thundergrj/Lumimoon-Tech-RobotDuck/致谢与许可.md

# 致谢与许可

## 致谢

这份中文组装调试教程，建立在一系列开源工作之上：

- **MicroDuck** — 由 Hugging Face / Pollen Robotics 开创的开源双足机器鸭，公开了软件栈与训练生态，让这只可爱的小鸭子走进全球开发者视野。
  https://pollen-robotics.com/microduck/
- **OpenMicroDuck** — 社区对 MicroDuck 的开源复刻项目，公开了适配国产供应链的硬件图纸、PCB、BOM、结构优化与文档。本教程的硬件知识、结构设计说明、选型逻辑主要整理、复述并再创作自该项目。
  https://github.com/JoyandAI/OpenMicroDuck
- **microduck_rl（HD-1910 适配 fork）** — 为飞特 HD-1910 舵机适配了执行器（BAM）参数的训练仓库。
  https://github.com/JoyandAI/microduck_rl

本教程是**独立编写**的中文装配 / 调试文档，为便于中文用户上手而重新组织、重写了内容，并补充了针对具体套件（HD-1910 C018、微雪控制板、IMX219 160°、LSM6DSV16X 桌面调试版等）的实操说明。本教程与上述团队 / 公司无隶属关系。

如内容有误或可改进，欢迎到 OpenMicroDuck 仓库提 Issue / PR，一起把中文文档做得更好。

## 许可

本教程文档采用 **CC BY-SA 4.0**（署名—相同方式共享），与上游 OpenMicroDuck 的教程 / 文档许可一致：

- **署名（BY）**：复制、修改、再分发时，请保留对 OpenMicroDuck / MicroDuck 的署名与来源链接。
- **相同方式共享（SA）**：基于本教程的衍生作品，需以相同的 CC BY-SA 许可发布。

硬件相关内容的许可以上游项目为准：

| 内容 | 许可 |
| --- | --- |
| 硬件图纸、PCB、BOM | CERN-OHL-S |
| 软件栈、训练环境 | Apache-2.0 |
| 教程与文档 | CC BY-SA 4.0 |

> 图片说明：本仓库 `assets/` 下为占位示例，请替换为你自己拍摄 / 制作的图片。请勿直接搬运上游项目的图片而不署名。
