thundergrj/Lumimoon-Tech-RobotDuck/docs/11_接口与参数速查.md

# 09 · 接口与参数速查

装配、接线、调试时随手查这一页。

---

## 1. 舵机 ID 规划

```text
右腿   10 右髋yaw · 11 右髋roll · 12 右髋pitch · 13 右膝 · 14 右踝
左腿   20 左髋yaw · 21 左髋roll · 22 左髋pitch · 23 左膝 · 24 左踝
头颈嘴 30 脖pitch · 31 头pitch · 32 头yaw · 33 头roll · 34 鸭嘴
机身IMU 200（仅整机集成版，串在舵机链中 31 与 20 之间；桌面调试版 IMU 走主控 I²C，不用此 ID）
```

鸭嘴（34）是第 15 轴，**不参与走路策略**，由上层逻辑单独开合。

---

## 2. HD-1910 舵机关键参数

> 以 HD-1910 系列规格为参考（你的套件为 C018 批次，具体以随附规格书为准）。

| 项目 | 参数 |
| --- | --- |
| 类型 | 恒力空心杯总线舵机，金属齿 |
| 工作电压 | **4 – 8.4 V**（本套件用 7.5V 适配器） |
| 堵转扭矩 | 约 **12 kg·cm @ 6V**（约 1.18 N·m） |
| 额定扭矩 | 约 3 kg·cm @ 6V |
| 空载转速 | 约 92 rpm @ 6V |
| 减速比 | 320 : 1 |
| 编码器 | 12-bit 磁编码（0–4095，中位约 2048） |
| 接口 | **AMP2.0-3P** |
| 协议 | 飞特 TTL 半双工，8N1，数字包 |
| 通信波特率 | 统一设为 **1 Mbps** |
| 反馈 | 位置 / 速度 / 电流 / 电压 / 温度 / 负载 |
| ID 范围 | 0–253（出厂常见 ID 1） |

---

## 3. ⚠️ 针序对照（接线必看）

| 针位 | HD-1910（AMP2.0-3P） | Dynamixel / 飞特 HL 等 |
| --- | --- | --- |
| 1 | **Signal 信号** | GND 地 |
| 2 | Vcc 电源 | Vcc 电源 |
| 3 | **GND 地** | Signal 信号 |

> HD-1910 与 Dynamixel 针序**相反**，不能按 Dynamixel 线序直插。接 AMP2.0 转 5264 转接线前务必核对。

---

## 4. 波特率寄存器值对照（飞特 / Dynamixel 同类）

| 寄存器值 | 波特率 |
| --- | --- |
| 1 | 57 600（常见出厂默认） |
| 2 | 115 200 |
| **3** | **1 000 000（1 Mbps，本项目用）** |
| 4 | 2 000 000 |

> 出厂默认常不是 1 Mbps。用当前波特率扫到后，改成 1 Mbps 再统一使用。

---

## 5. 轴承用量

| 轴承 | 规格 | 数量 | 用途 |
| --- | --- | --- | --- |
| 6700K | 10 × 15 × 3 mm | 3 | 较小旋转关节 |
| ET2216 | 16 × 22 × 4 mm | 11 | 踝 / 腿等主要承重旋转处 |

## 6. 螺丝用量

| 规格 | 数量 | 用途 |
| --- | --- | --- |
| M2 × 5 自攻 | 60 | 锁大部分结构 |
| M2 × 6 自攻 | 60 | 锁舵盘、脚 |
| M2 × 8 自攻 | 20 | 锁舵机（成品版多为备用） |
| M2.5 × 6 自攻 | 20 | 头部内部结构 |

---

## 7. 主控（Radxa ZERO 3W）与鸭子相关接口

| 接口 | 用途 |
| --- | --- |
| UART2_M0（40-pin 8 脚 TX / 10 脚 RX） | 舵机总线（整机集成版经 HAT）。**系统里默认被 serial-getty 占用，需 mask**；开机阶段是 U-Boot 调试口（1500000） |
| I²C3（40-pin 3/5 脚） | IMU（桌面调试版）、ToF、codec |
| MIPI CSI（22-pin） | IMX219 摄像头 |
| I²S | 喇叭 / codec |
| USB-C 1（OTG） | **唯一供电口**，仅 5V（≥ 5V/2A）+ 刷机 |
| USB-C 2（USB 3.2 Host） | 接外设（如 USB 舵机驱动板），**不能供电** |
| Micro HDMI | 1080p60 显示（配置时用） |
| Wi-Fi 6 / BT 5.4 | 配网 / 蓝牙 |

> 完整接口与引脚说明：[Radxa ZERO 3 硬件接口文档](https://docs.radxa.com/zero/zero3/hardware-design/hardware-interface)；接口实物图见 [08 章 §0](08_主控系统与刷机.md)。

---

## 8. 控制契约（软件）

| 项 | 值 |
| --- | --- |
| 控制频率 | 50 Hz |
| 观测维度 | 61（陀螺 3 + 重力投影 3 + 关节位置 14 + 关节速度 14 + 上一动作 14 + 指令 13） |
| 动作维度 | 14（14 个走路关节，不含鸭嘴） |
| 策略格式 | ONNX（主控 CPU 上用 ONNX Runtime 跑） |
| 走路是否用 NPU | 否（NPU 留给视觉） |

---

## 9. 供电速查

| 对象 | 供电 |
| --- | --- |
| 舵机 + 控制板 | 7.5V 适配器（范围内） |
| 主控 | 5V/2–3A PD（Type-C） |
| IMU 模组 | 3.3V（**勿接 5V**） |
