thundergrj/Lumimoon-Tech-RobotDuck/docs/06_通电自检与联调.md

# 06 · 通电自检与联调

到这一步，机械装好了、舵机也都编好号校好中位了。本章把整条总线一起通电，做系统级自检，让机器鸭第一次整机"活"起来。

---

## 路线一用户看这里（成品 / 半成品套件）

如果你买的是舵机已装好的整机 / 半成品，前面 02 / 03 跳过没关系，但 **04 接线和 05 舵机调试这两步不能省**：

1. 先读 [04 电子接线](04_电子接线与舵机总线.md)，把控制板、电源、（主控 / IMU / 摄像头）接好。
2. 再按 [05 舵机调试](05_舵机调试_ID与中位校准.md) **确认** 15 个舵机的 ID、波特率、中位。
   - 成品版通常出厂已编好 ID。你要做的是**验证**：整条总线一起扫，看是否能扫到全部 15 个 ID（见下）。
   - 如果扫不全，照 [05](05_舵机调试_ID与中位校准.md) 把缺的那个单独接出来补设。

然后回到本章做整机自检。

---

## 1. 上电顺序与检查

**接线确认 → 上电 → 观察**，别颠倒。

1. 再过一遍 [04 的接线检查清单](04_电子接线与舵机总线.md)。
2. 先给**主控**上电（5V PD），让它正常启动。
3. 再给**舵机总线**上电（7.5V 适配器）。
4. 上电瞬间盯住：有没有哪个舵机**异常发烫、冒烟、剧烈抖动**，有没有闻到焦味。任何异常**立刻断电**，回 [04](04_电子接线与舵机总线.md) 查线序 / 短路。

> 分开两路电源的好处：万一舵机那路有问题，主控不受影响，排查更清楚。

---

## 2. 整线扫描：15 个舵机一个都不能少

把全部 15 个舵机串好、通电，用上位机（或主控上的扫描工具）在 **1 Mbps** 下扫描整条总线：

- 期望扫到 **15 个 ID**：10–14、20–24、30–34。
- **对照检查**：

| 应扫到的 ID | 部位 | 扫到? |
| --- | --- | --- |
| 10 11 12 13 14 | 右腿 5 关节 | ☐ |
| 20 21 22 23 24 | 左腿 5 关节 | ☐ |
| 30 31 32 33 | 脖 + 头三轴 | ☐ |
| 34 | 鸭嘴 | ☐ |

扫不全时的常见原因：

- 少某一个 → 那个舵机线没串好 / 转接处接触不良 / 它的波特率没统一到 1 Mbps。
- 一个都扫不到 → 控制板到总线那段线序错（特别是 1 = 信号这一点，见 [04 §3](04_电子接线与舵机总线.md)）、或没供电、或串口选错。
- 两个 ID 冲突（扫到的数量少于 15 且某动作时两个一起动）→ 有重复 ID，逐个排查重设。

---

## 3. 整机回中位：看站姿

全部扫到后，让所有关节回到中位：

- 机器鸭应能**对称地站直**：双腿对称、双脚平行着地、头正对前方、鸭嘴闭合。
- 哪里不对，就能反推哪个关节中位没校准好：
  - 一条腿比另一条歪 → 查该腿对应关节的中位和装配角度。
  - 脚不平、前倾后仰 → 查踝 / 髋 pitch。
  - 头歪 → 查头三轴（31/32/33）。

> 第一次让整机站立时，**用手扶着**或让它坐在支架上，别让它直接自己站——还没有平衡策略，它是会倒的。

> 📷 *待补拍：整机回中位，扶着确认对称站姿*

---

## 4. 分部位点动联调

确认站姿后，分部位做小幅点动，验证每个关节在整机状态下都正常：

1. **头颈**：让头 yaw / pitch / roll 各小幅转动，确认转向正确、不打架、不蹭壳。
2. **鸭嘴**：开合几次，确认顺畅（卡顿参考 [02](02_3D打印指南.md) / [10 FAQ](10_常见问题FAQ.md) 的 `jaw_soft` 处理）。
3. **腿部**：悬空（把鸭子托起或架高，脚不落地）状态下，让髋 / 膝 / 踝小幅活动，确认左右对称、方向正确。
4. 全程留意电流 / 温度反馈，有持续高电流或快速升温的关节，先停下查机械是否卡滞。

> **安全第一**：联调点动阶段，幅度从小到大；腿部测试尽量悬空做，避免它突然发力把自己掀翻或夹到手。

---

## 5. IMU 自检（桌面调试版）

- 在主控上确认能读到 LSM6DSV16X（I²C 能扫到地址、能读出陀螺仪 / 加速度数据）。
- 轻轻倾斜 / 转动机体，数据应随之变化；静止时陀螺仪接近 0、加速度指示重力方向。
- 这步为后续平衡控制环打基础。具体读取方法见 [08 主控系统与刷机](08_主控系统与刷机.md)。

---

## 6. 联调验收

- [ ] 整线扫描能稳定扫到全部 15 个舵机（1 Mbps）
- [ ] 回中位后整机对称站立（扶着）
- [ ] 头颈、鸭嘴、双腿分部位点动正常、方向正确、不蹭壳
- [ ] 无持续过流 / 过热关节
- [ ] IMU 能读数、随姿态变化

到这里，**硬件装配与调试就全部完成了**——你已经有一只"装好、接好、能动、能感知"的机器鸭。接下来是让它自己站稳、会走的软件与策略部分 → [08 主控系统与刷机](08_主控系统与刷机.md) · [09 仿真、步态与强化学习](09_仿真步态与强化学习.md)

遇到问题先查 [10 常见问题 FAQ](10_常见问题FAQ.md)。
