thundergrj/Lumimoon-Tech-RobotDuck/docs/01_物料清单与工具.md

# 01 · 物料清单与工具

本章先带你把到手的一整套东西清点一遍：每样是什么、派什么用、为什么是这个规格。装之前花十分钟对清单，比装到一半发现缺件强得多。

> 本教程按**有线调试套件**（桌面调试版）编写：主控和舵机控制板放在机体外面，用电源适配器供电、数据线连电脑，先把控制和策略跑通。这是最稳的入门路径。等整机集成版的 HAT 转接板就绪后，再把电池和线束收进机体。

---

## 1. 整套物料总览

下表是一套完整有线调试套件的内容。**标配**是机器鸭本体必须的；**赠送**是装配要用到的结构件与五金；**选配（有线调试散件）**是把它调起来、让它"活"过来的那部分电子件。

### 标配

| 物料 | 型号 / 规格 | 数量 | 说明 |
| --- | --- | --- | --- |
| 舵机 | 飞特 HD-1910（C018 批次） | 15 | 恒力空心杯总线舵机，机器鸭的 15 个关节。**成品套件中已装在机体上**；散件套件则需自行安装 |

> **关于"15 个舵机"**：腿部每条 5 个（髋 yaw / roll / pitch + 膝 + 踝），左右共 10 个；头颈 4 个（脖子 pitch、头 pitch / yaw / roll）；鸭嘴 1 个。鸭嘴这颗（第 15 轴）不参与走路策略，由上层逻辑单独开合。

### 赠送（结构件与五金）

| 物料 | 规格 | 数量 | 说明 |
| --- | --- | --- | --- |
| 小鸭子打印件 | PLA + 脚底 TPU | 1 套 | 整机外壳与结构件。颜色分组见下 |
| 轴承 6700K | 10 × 15 × 3 mm | 3 | 用于较小的旋转关节 |
| 轴承 ET2216 | 16 × 22 × 4 mm | 11 | 用于踝 / 腿等主要承重旋转处 |
| 螺丝 | M2 × 5 自攻 | 60 | 锁大部分结构 |
| 螺丝 | M2 × 6 自攻 | 60 | 锁舵盘、脚等 |
| 螺丝 | M2 × 8 自攻 | 20 | 锁舵机（成品版舵机已装好，这部分多为备用 / 少量加固） |
| 螺丝 | M2.5 × 6 自攻 | 20 | 头部内部结构固定 |
| 转接线 | AMP2.0 转 5264（AMP 转 5264 端子） | 1 套 | 把舵机的 AMP2.0 口接到控制板的 5264 口，调试必备 |
| 安装工具 | M3 十字螺丝刀 | 1 | 基础拧螺丝工具 |

**打印件颜色分组**（共 36 件）：

| 颜色 | 数量 | 典型部位 |
| --- | --- | --- |
| 橙色 | 6 | 外观装饰 / 面部等 |
| 灰色 | 24 | 主体结构件（腿、胯、躯干、脖子等） |
| 白色 | 7 | 外壳 / 头壳等 |
| 黄色 | 3 | 其中 **2 个脚底用 TPU** 打印（软质，防滑、缓冲） |

> 完整的结构件逐件名称、打印材料与参数见 [02 3D 打印指南](02_3D打印指南.md)。成品套件无需关心这一章。

### 选配（有线调试散件）

| 物料 | 型号 / 规格 | 数量 | 说明 |
| --- | --- | --- | --- |
| 舵机控制板 | 微雪（Waveshare）总线舵机驱动板 | 1 | 调试的"总线入口"：一头 Type-C 连电脑，一头接舵机总线，用来改 ID、校中位、点动测试 |
| 摄像头模组 | IMX219，160° 广角，MIPI FPC 排线 | 1 | 500 万像素 CSI 摄像头，接主控的相机口。走路不依赖它，视觉功能才用 |
| SD 卡 | 64 GB TF 卡（A2） | 1 | 主控的系统盘（主控无 eMMC 时必需） |
| 读卡器 | USB TF 读卡器 | 1 | 给 SD 卡刷系统用；笔记本自带读卡器就不必另用 |
| IMU 模组 | LSM6DSV16X 模块（桌面调试版） | 1 | 六轴陀螺仪 + 加速度计，机器鸭的"内耳"。桌面调试版直接挂主控的 I²C / SPI |
| 数据线 | USB 转 Type-C | 1 | 连控制板 / 主控与电脑 |
| 电源适配器 | 7.5 V（有线供电，非锂电池） | 1 | 给舵机 / 控制板供电。7.5 V 落在 HD-1910 的 4–8.4 V 工作范围内 |

> **桌面调试版 vs 整机集成版**：你这套是**桌面调试版**——IMU 用的是现成模组、直接挂主控；供电用适配器而不是电池。好处是零件现成、能立刻开调，不必等整机用的 HAT 转接板和 IMU 转接板。等整机集成版就绪，会把 IMU 换成挂在舵机总线上的转接板（从机 ID 200）、供电换成可拆的 18650 电池组。

---

## 2. 自己另外要准备的东西

套件通常不含下面这些，但装配 / 调试会用到，建议提前备好：

- **PD 充电头 + Type-C 线**（给主控单独供电，5V/2A 或 5V/3A）。调试时主控和舵机分开供电更清晰。
- **Micro HDMI 转 HDMI 线 + 一台显示器**（可选）：第一次给主控配网、看桌面时方便；熟练后可纯命令行远程，不接屏。
- **尖嘴镊子 / 挑针**：穿排线、理线、塞螺母时好用。
- **电烙铁 + 焊锡**（散件 / 需要自己接线时）：接麦克风、喇叭、加长电源线会用到。
- **万用表**：接线后、通电前量一下电源正负极有没有接反、有没有短路，花一分钟能省一块板子。
- **PLA / TPU 耗材与 3D 打印机**（仅散件且需要自己补打印件时）。
- **扎带 / 热缩管 / Kapton 胶带**：理线、固定、绝缘。

---

## 3. 开箱清点清单（装配前先做）

按下面逐项打勾，缺件先联系卖家补，别急着下手：

- [ ] 15 个舵机齐全，线材无破损；成品版确认每个关节舵机都已固定、舵盘无松动
- [ ] 打印件按颜色清点：橙 6 / 灰 24 / 白 7 / 黄 3（含 2 个 TPU 脚底），无明显断裂、缺层、翘边
- [ ] 轴承：10×15×3 共 3 个、16×22×4 共 11 个，转动顺滑无卡滞
- [ ] 螺丝四种规格数量大致够用（M2×5、M2×6、M2×8、M2.5×6）
- [ ] AMP2.0 转 5264 转接线 1 套，端子无歪针
- [ ] 舵机控制板（微雪）1 块，Type-C 口正常
- [ ] 摄像头模组 + FPC 排线，排线无折痕
- [ ] SD 卡 + 读卡器
- [ ] IMU 模组（LSM6DSV16X 桌面调试版）
- [ ] 数据线、7.5 V 电源适配器
- [ ] 螺丝刀等工具

> **小贴士**：找几个带格子的零件盒，把四种螺丝分开放、贴上标签。整个装配过程最容易出错的就是"拿错螺丝长度"——M2×5 和 M2×8 混在一起，装到后面会很头疼。

---

## 4. 关键规格为什么是这样（选读）

花几句话解释几个"为什么"，装的时候心里更有数：

- **为什么是总线舵机，而不是航模舵机**：机器鸭要跑 50 Hz 的闭环控制，每一拍都要读回每个关节的**位置、速度、电流**；还要能"恒力"——摔倒时卸力、落地时缓冲、鸭嘴夹东西时不硬顶。普通 PWM 航模舵机给不了这些反馈，也没有恒力模式。
- **为什么电源是 7.5 V**：HD-1910 的工作电压是 4–8.4 V，7.5 V 正好落在中间偏上，扭矩足、又不超压。注意这套用的是**适配器有线供电**，不是锂电池——调试阶段更安全、也不用等电池。
- **为什么 IMU 很关键**：没有 IMU，机器人就不知道自己"歪没歪"。它提供的陀螺仪（角速度）和重力方向，是平衡控制环最核心的输入之一。
- **为什么要一块专门的舵机控制板**：15 个舵机挂在**同一条总线**上，靠 ID 区分。出厂舵机 ID 往往都一样、波特率也不一定对。控制板就是你和这条总线对话的工具——改 ID、设波特率、校零点、单独点动，都靠它。详见 [05 舵机调试](05_舵机调试_ID与中位校准.md)。

---

下一步：

- 散件用户 → [02 3D 打印指南](02_3D打印指南.md)
- 成品 / 半成品用户 → 直接去 [04 电子接线与舵机总线](04_电子接线与舵机总线.md)
