thundergrj/Lumimoon-Tech-RobotDuck/resources/HD1910 开源资料/开源资料/xgoduck_hardware-master/bom.xlsx

Index | Part Name | Quantity | Purchase Link
1 | Arduino Uno q | 1 | https://store.arduino.cc/
2 | Robot Expansion Board | 1
3 | AMP 3Pin Cable | 15 | https://detail.1688.com/offer/1079246394282.html
4 | Feetech 1910 | 15
5 | 18650 battery 8.4V | 1 | XH2.54 Battery capacity > 2,500 mAh; discharge rating > 3C.
6 | Countersunk screw M2*6 | 200
7 | screw M2.5*6 | 6
8 | screw M3*16 | 4
9 | Bearing 10*15*3 | 2
10 | Bearing 16*22*4 | 11
