thundergrj/Lumimoon-Tech-RobotDuck/resources/HD1910 开源资料/3D/HD-1910-C001-20260902.stp

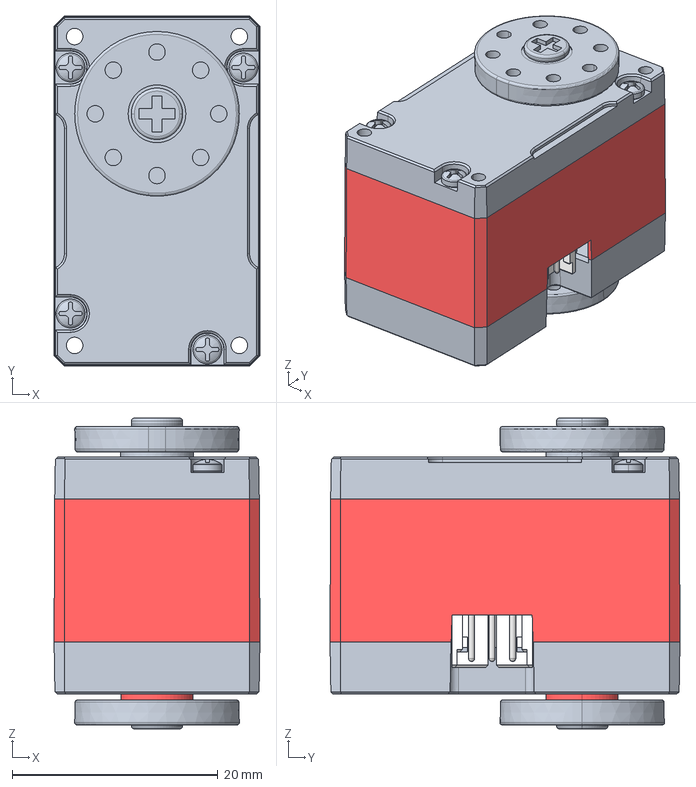
[picture p8: CAD file, 2026-10-18]
resources/HD1910 开源资料/3D/HD-1910-C001-20260902.stp
20.0 x 34.0 x 30.2 mm
SJ-WK00-0140-MIDDLECASE_49
OUTPUTGEAR_1
AMP-3P-2_1 x 2
SJ-WK00-0138-TOPCABINET_6
SJ-WK00-0142-BOTTOMCASE_26
SJ-FDP0-0004-HORN_IDLE2_14
SJ-DP00-0003_HORN_7
PHS_1_7X20_5_DC10_3_1 x 4
