thundergrj/Lumimoon-Tech-RobotDuck/(commit log)

2026-10-11 初始提交：MicroDuck 机器鸭中文组装与调试教程（11 章 + 实拍图 + 结构框图）
2026-10-18 新增 12 章整机接线，并补充组装/接线配图
    新增：
    - docs/12_整机接线_电源与IMU.md — HAT 供电（电池接哪个口、① 脚位置、
    万用表验证、板上无保险丝无防反接）、IMU_to_DXL 怎么挂（不接舵机、
    挂末端、两组座子脚序相反）、独立 IMU 模组接 RK3566（40 针 / Qwiic
    两种情形、地址冲突、安装朝向与零点校准）
    - assets/03_assembled_duck.jpg — 机械装配完成的整机（ch03 章首）
    - assets/04_wiring_desktop.png — 桌面调试版接线图（ch04 §1）
    - assets/12_boards_overview.jpg — 四块板实拍（ch12 章首）
    - assets/12_wiring_integrated.png — 整机集成版总线拓扑（c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
2026-10-18 新增resources文件夹
2026-10-21 新增整体组装与接线
